audreifilhorossato/InkHand/docs/photos/F001.jpg

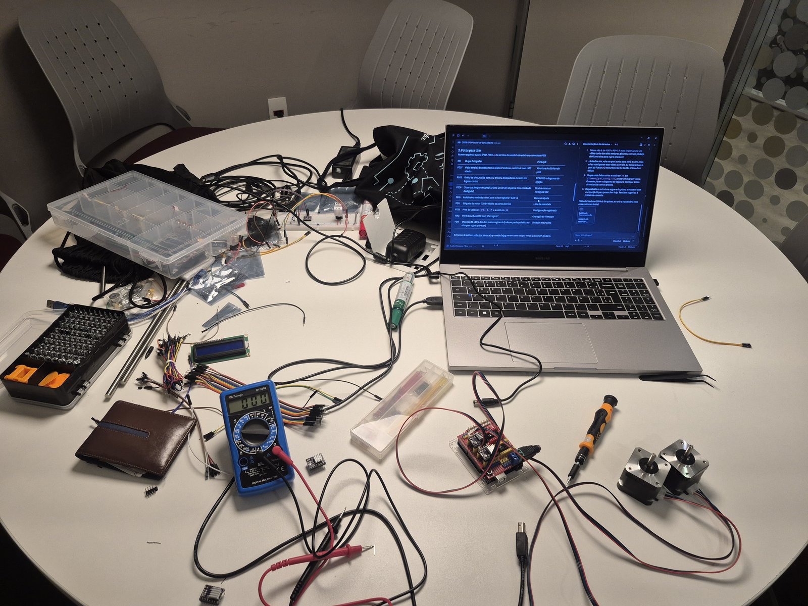
docs/photos/F001.jpg
