audreifilhorossato/InkHand/docs/photos/F002.jpg

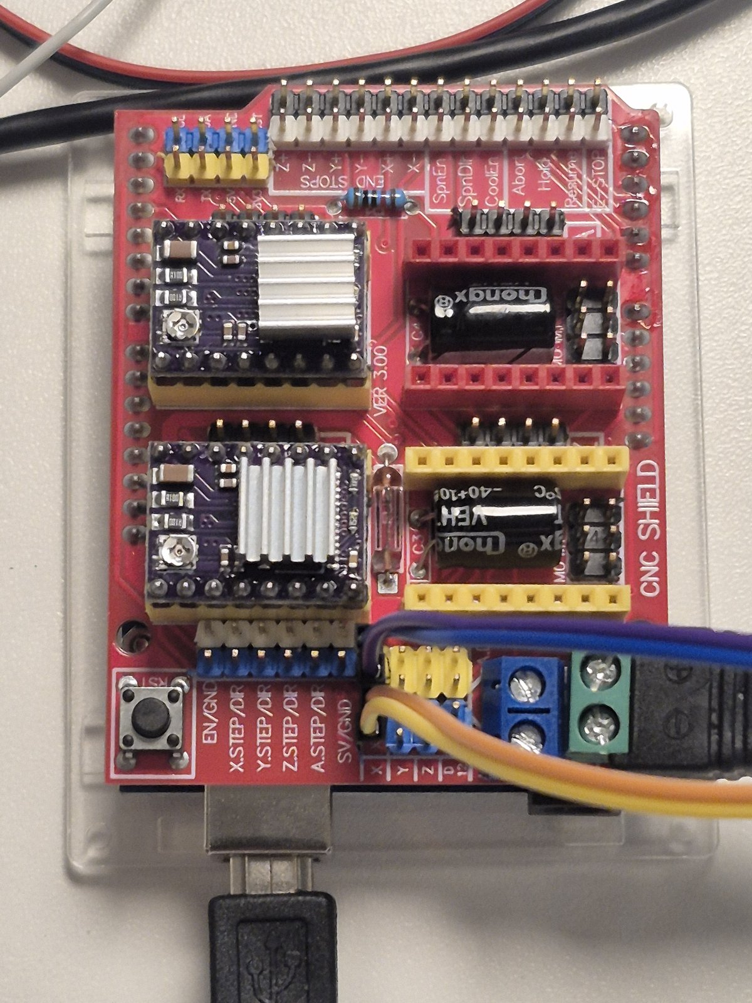
docs/photos/F002.jpg
