audreifilhorossato/InkHand/docs/photos/F003.jpg

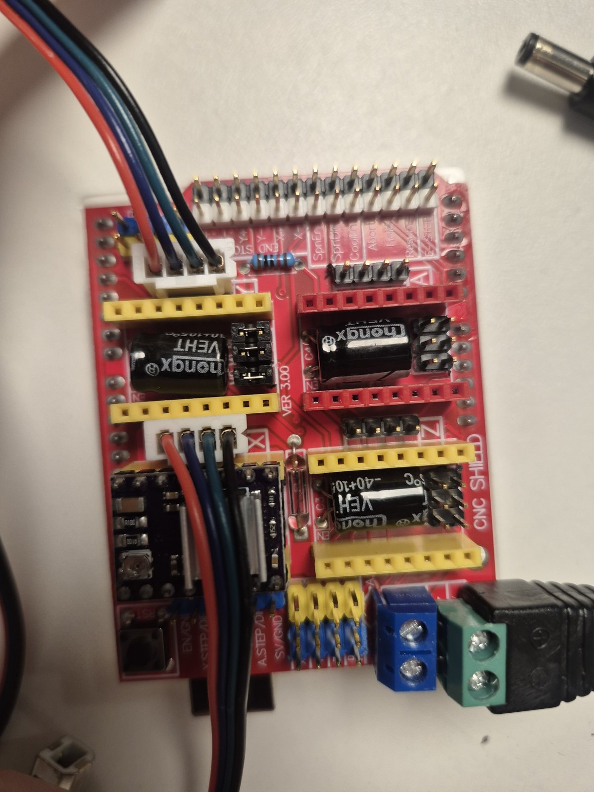
docs/photos/F003.jpg
