audreifilhorossato/InkHand/docs/photos/F004.jpg

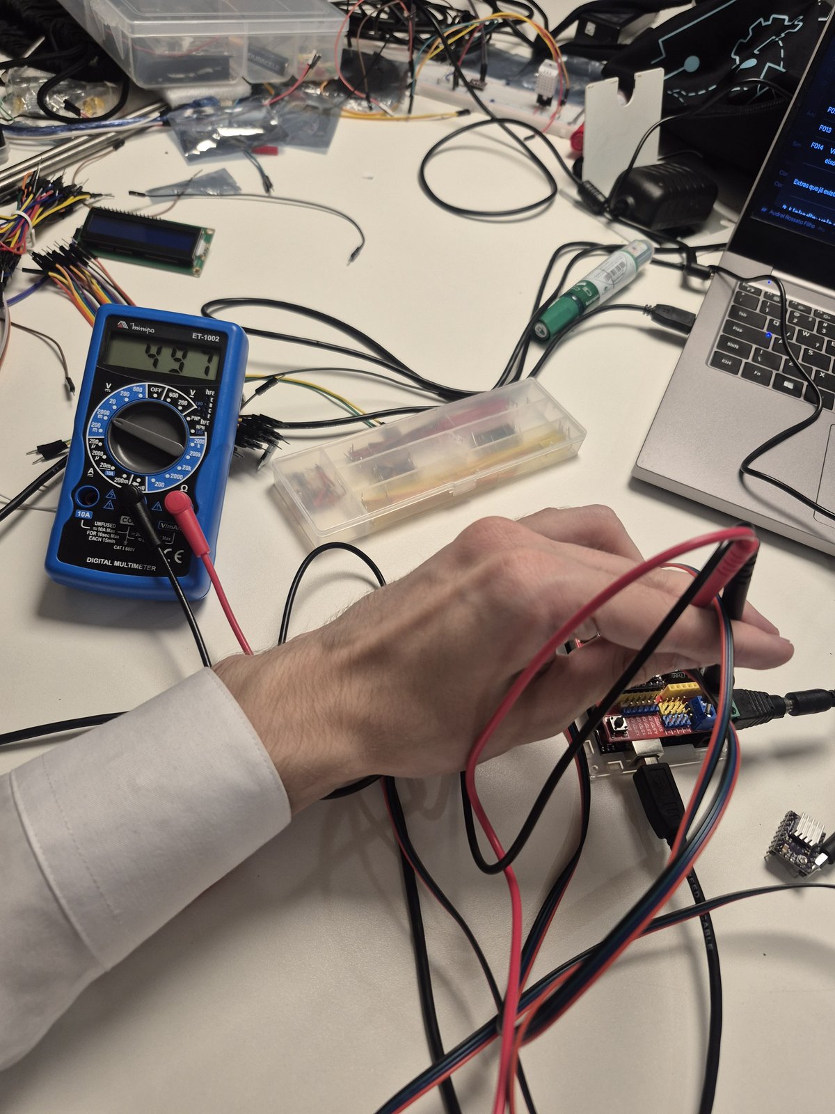
docs/photos/F004.jpg
