audreifilhorossato/InkHand/docs/photos/F005.jpg

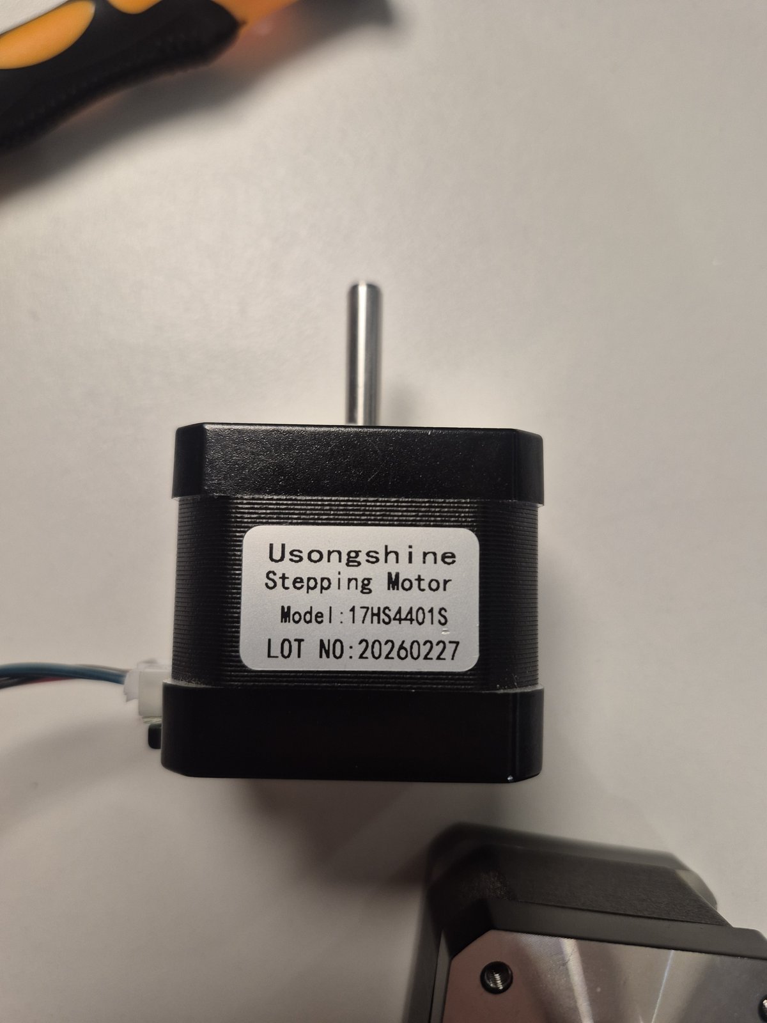
docs/photos/F005.jpg
