audreifilhorossato/InkHand/docs/photos/F006.jpg

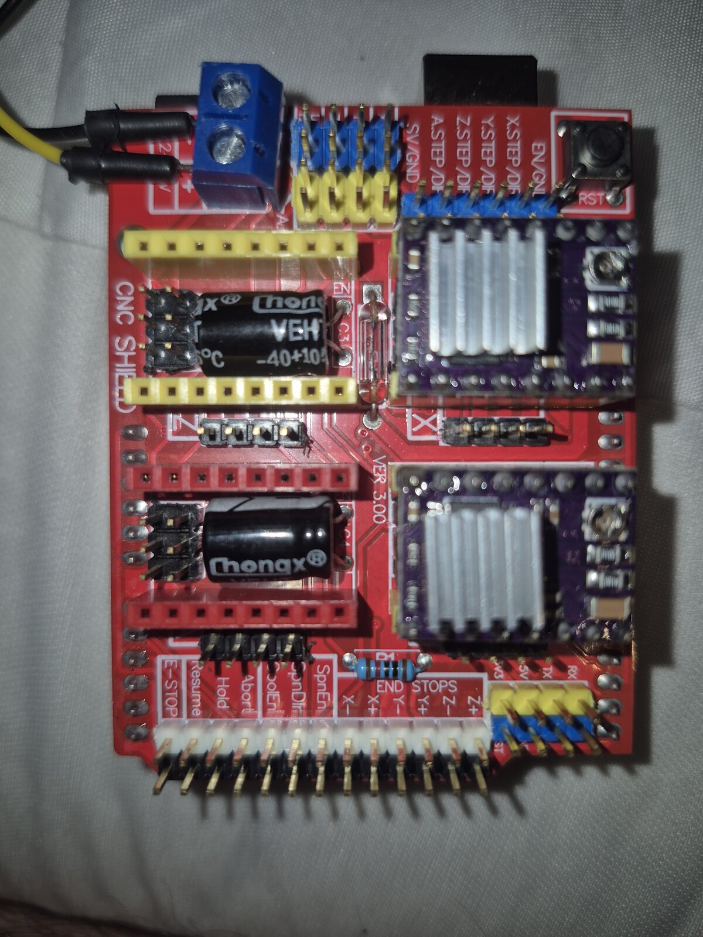
docs/photos/F006.jpg
