audreifilhorossato/InkHand/docs/photos/F007.jpg

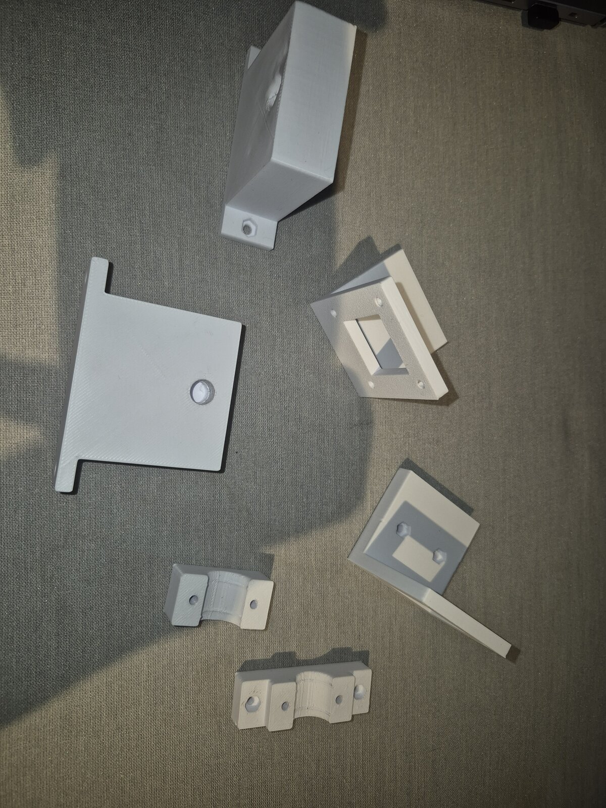
docs/photos/F007.jpg
