audreifilhorossato/InkHand/docs/photos/F008.jpg

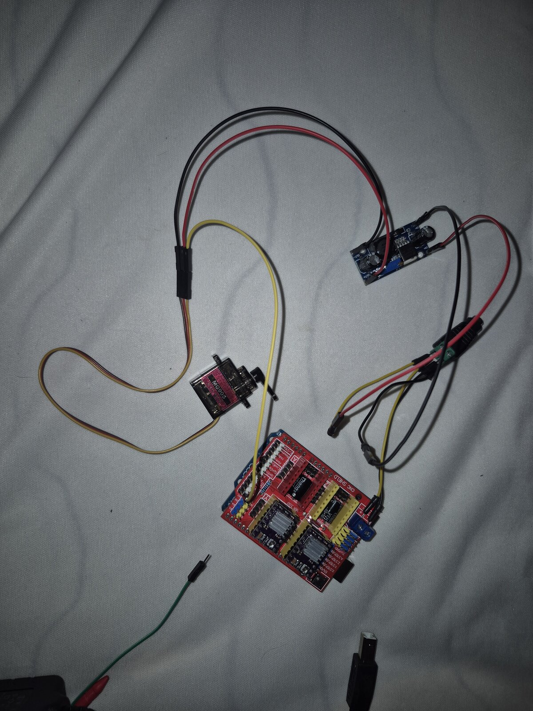
docs/photos/F008.jpg
