audreifilhorossato/InkHand/docs/photos/F009.jpg

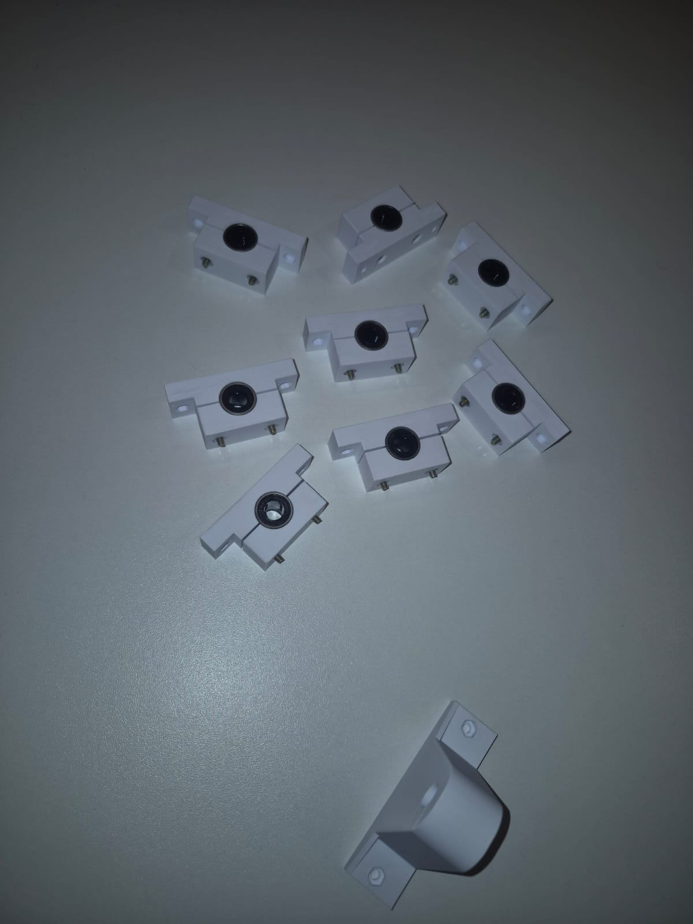
docs/photos/F009.jpg
