audreifilhorossato/InkHand/docs/photos/F010.jpg

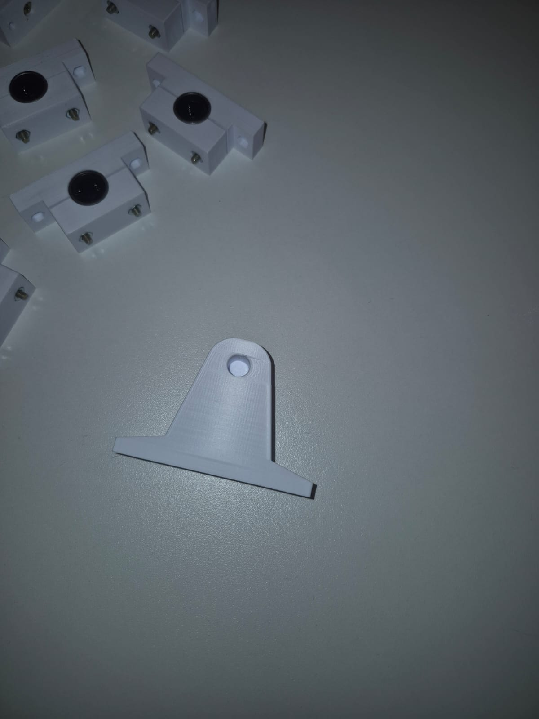
docs/photos/F010.jpg
