audreifilhorossato/InkHand/docs/photos/F011.jpg

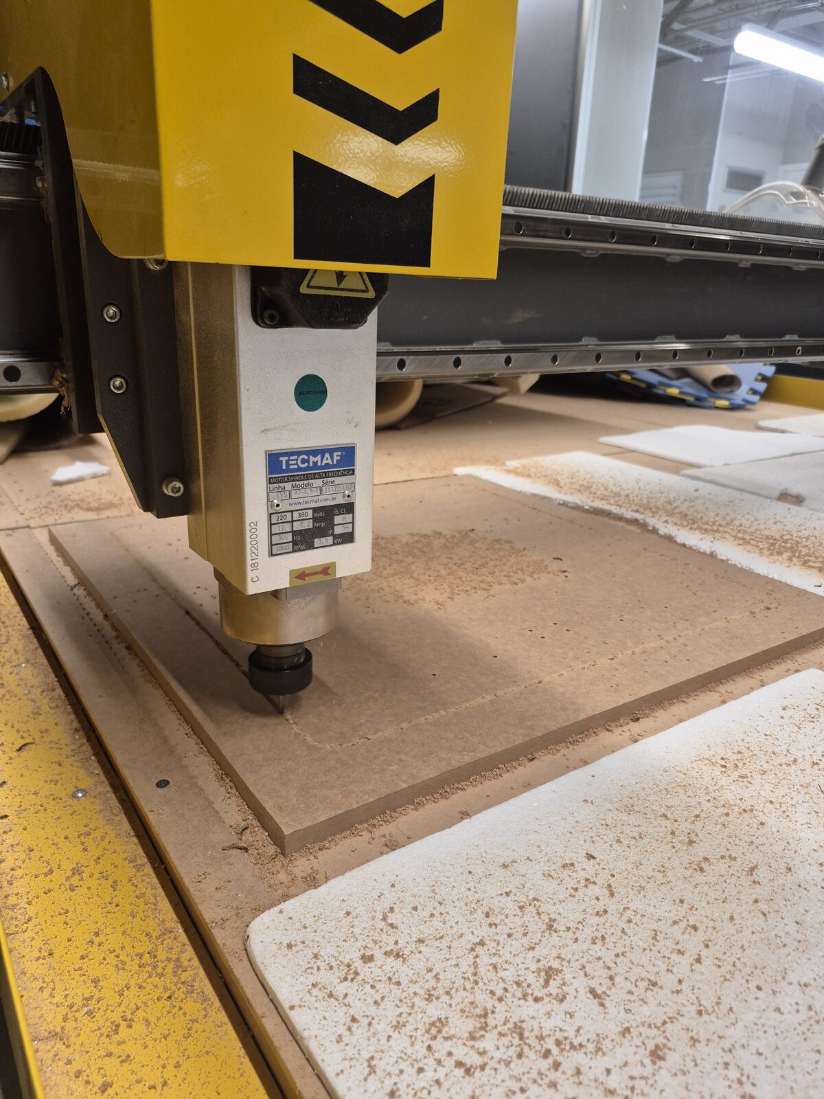
docs/photos/F011.jpg
