audreifilhorossato/InkHand/docs/photos/F012.jpg

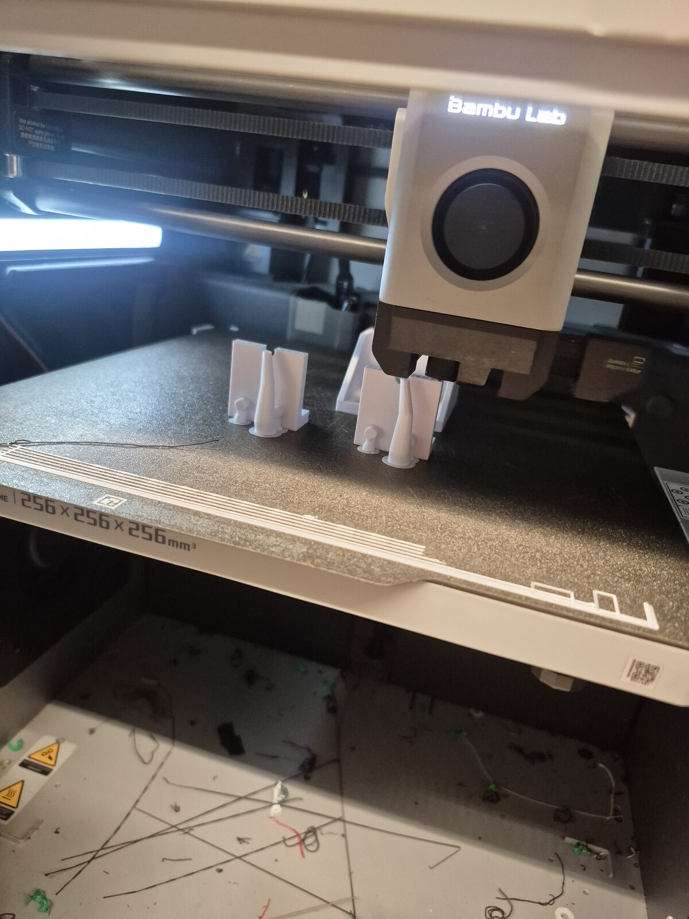
docs/photos/F012.jpg
