audreifilhorossato/InkHand/docs/photos/F013.jpg

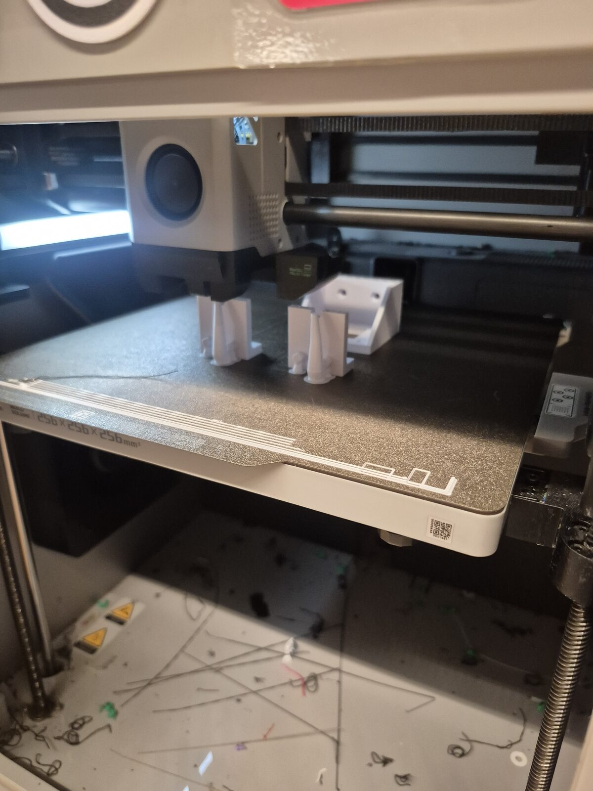
docs/photos/F013.jpg
