audreifilhorossato/InkHand/docs/photos/F014.jpg

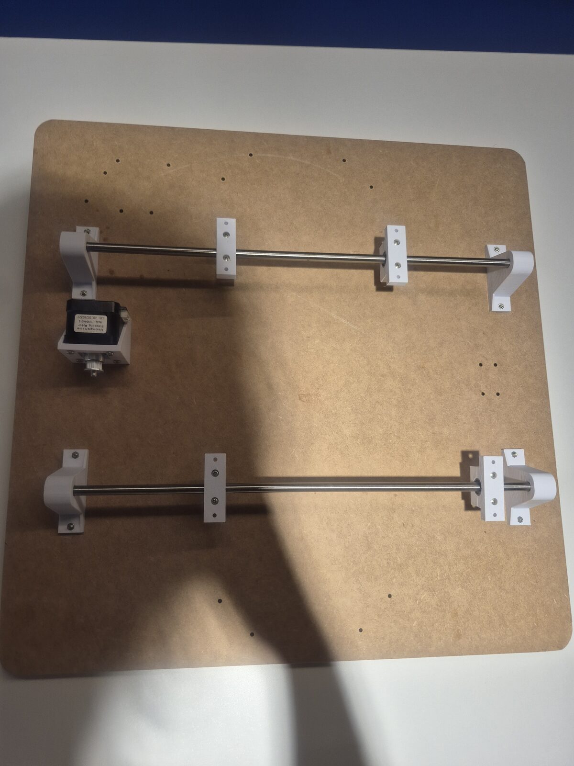
docs/photos/F014.jpg
