audreifilhorossato/InkHand/docs/photos/F015.jpg

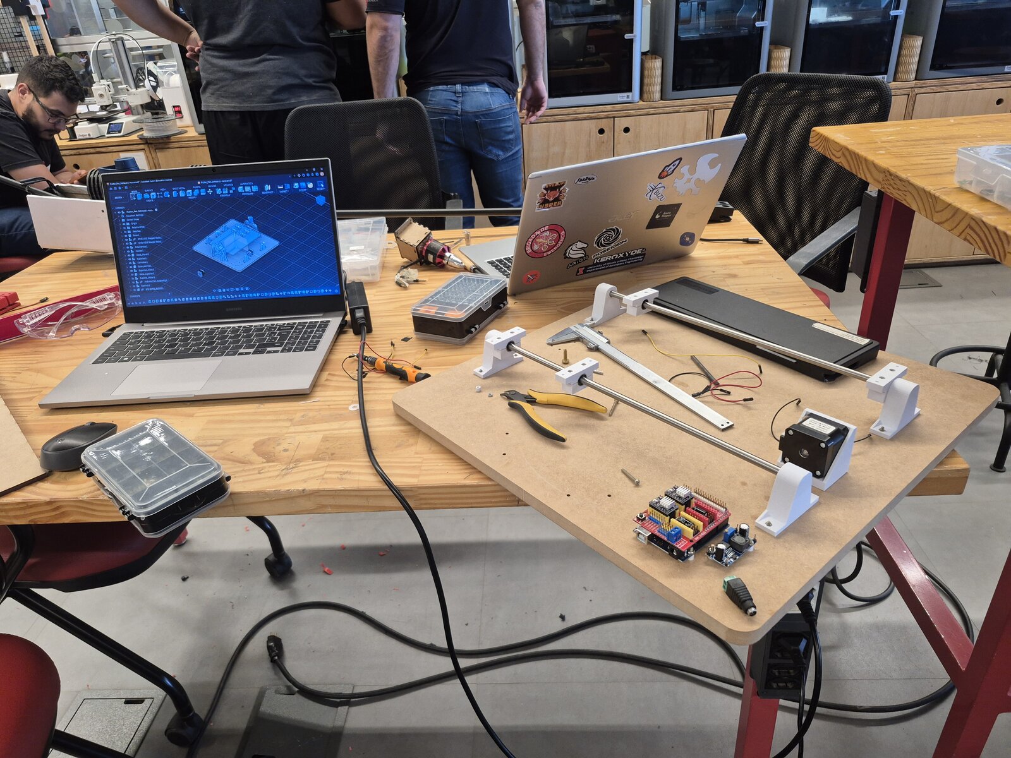
docs/photos/F015.jpg
