audreifilhorossato/InkHand/docs/photos/F016.jpg

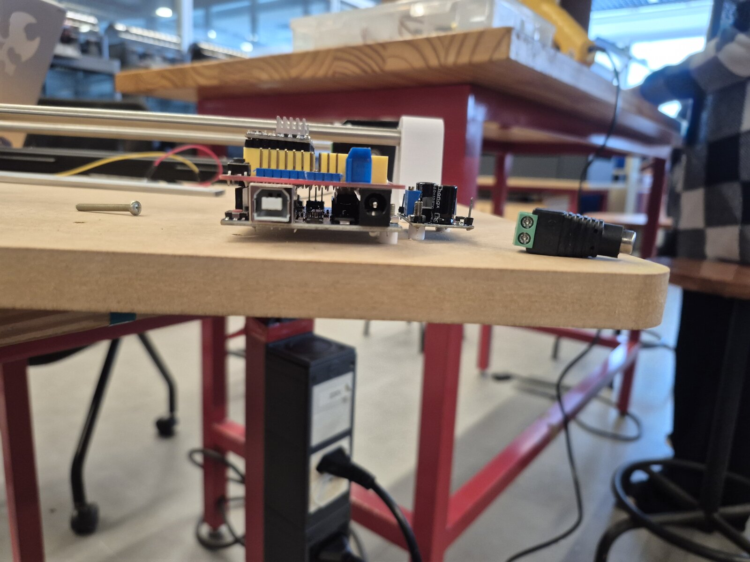
docs/photos/F016.jpg
