audreifilhorossato/InkHand/docs/photos/F017.jpg

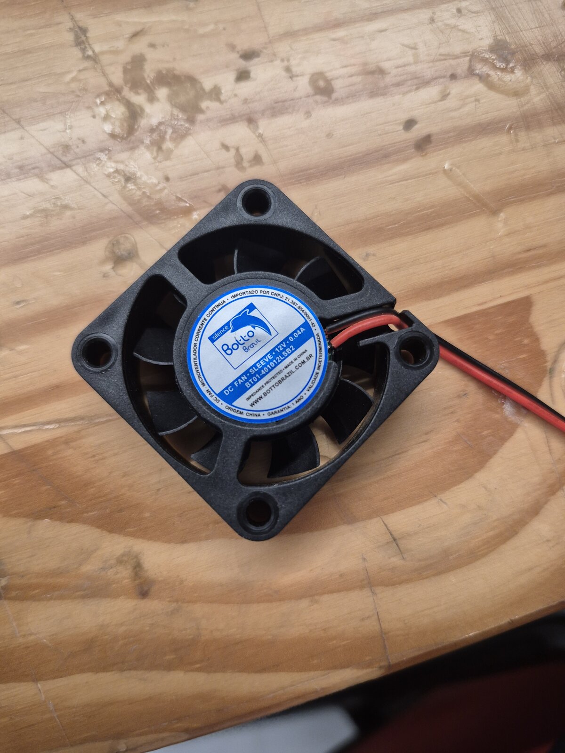
docs/photos/F017.jpg
