audreifilhorossato/InkHand/docs/photos/F018.jpg

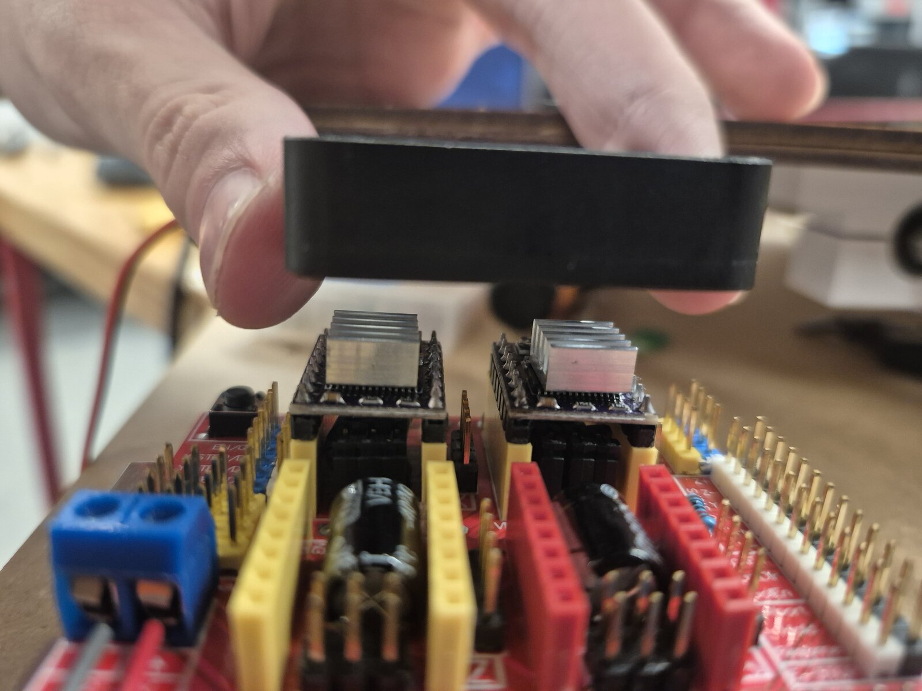
docs/photos/F018.jpg
