audreifilhorossato/InkHand/docs/photos/F019.jpg

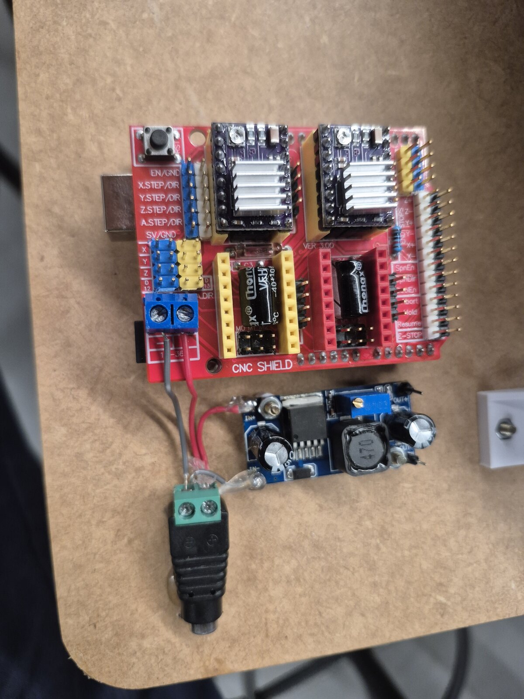
docs/photos/F019.jpg
