audreifilhorossato/InkHand/docs/photos/F020.jpg

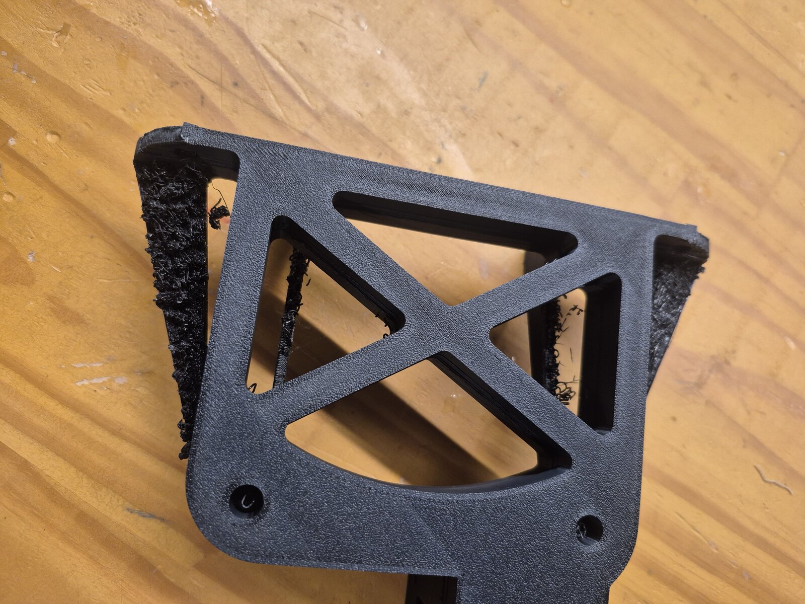
docs/photos/F020.jpg
