audreifilhorossato/InkHand/docs/photos/F021.jpg

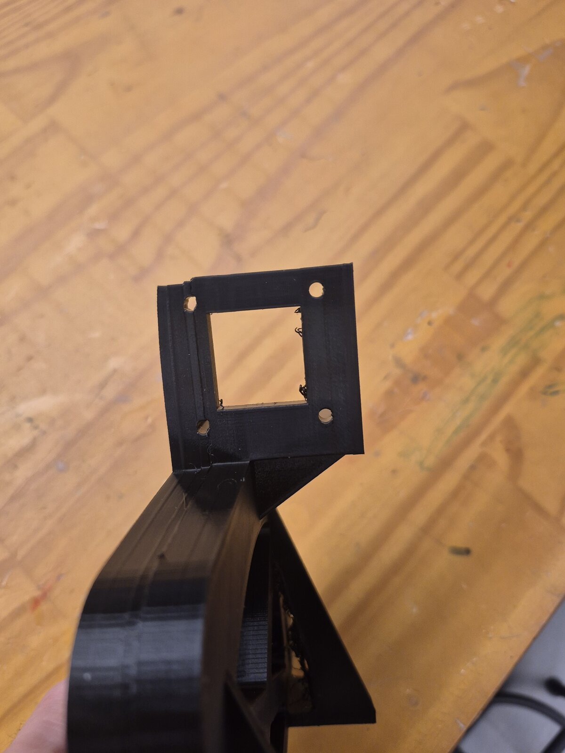
docs/photos/F021.jpg
