audreifilhorossato/InkHand/docs/photos/F022.jpg

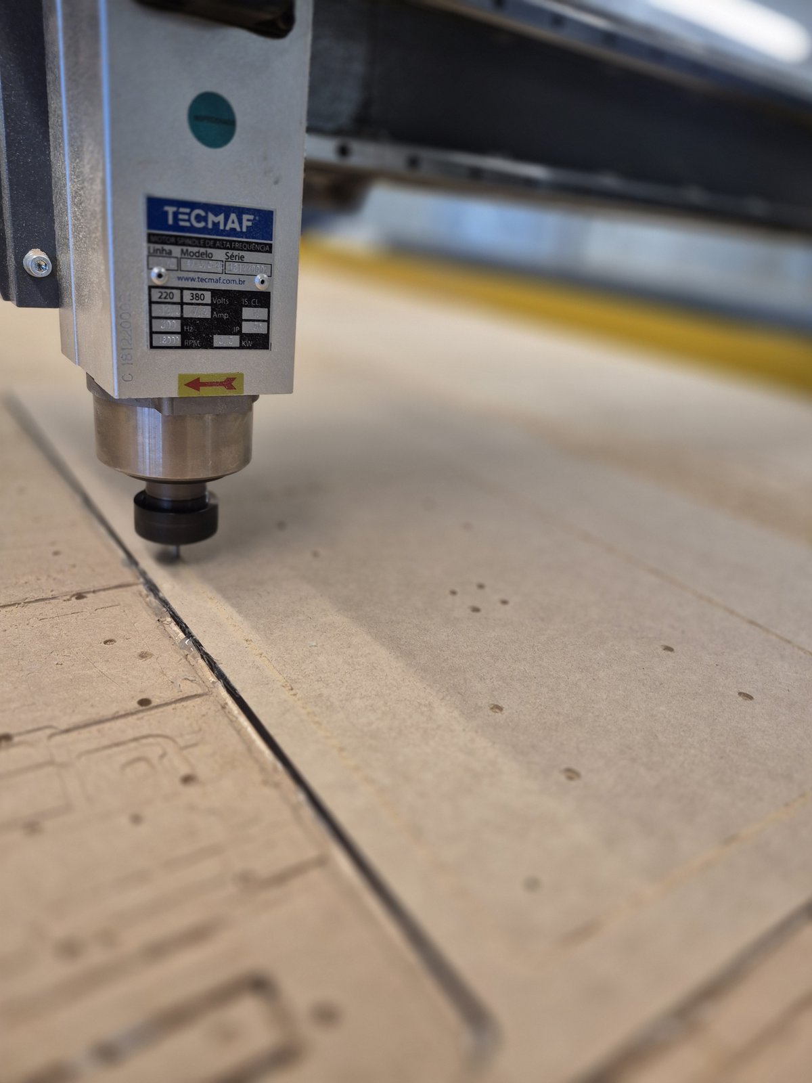
docs/photos/F022.jpg
