audreifilhorossato/InkHand/docs/photos/F023.jpg

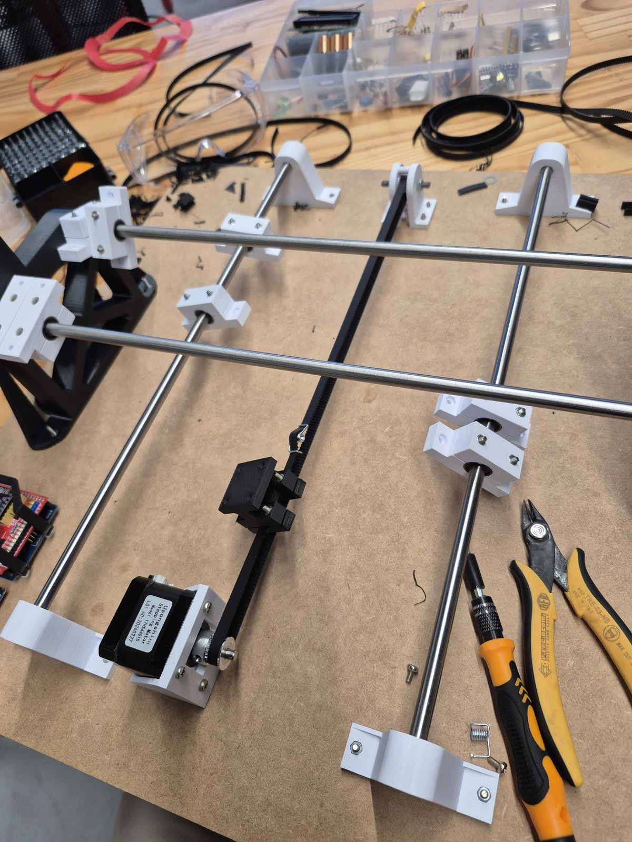
docs/photos/F023.jpg
