audreifilhorossato/InkHand/docs/photos/F024.jpg

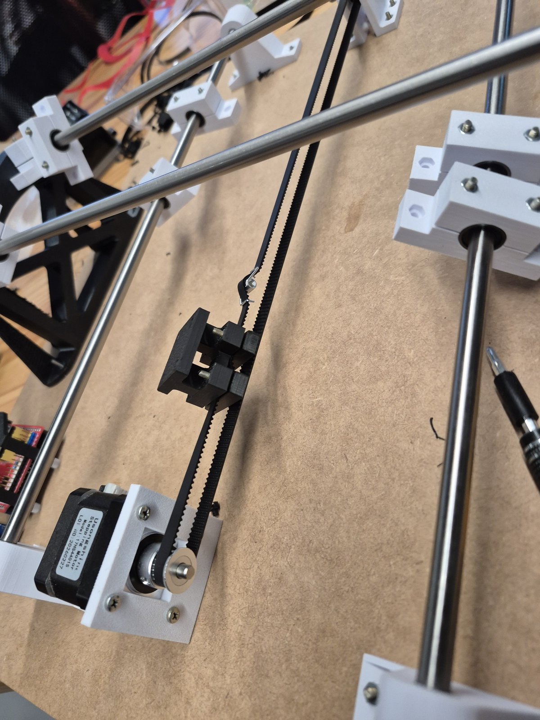
docs/photos/F024.jpg
