audreifilhorossato/InkHand/docs/photos/F025.jpg

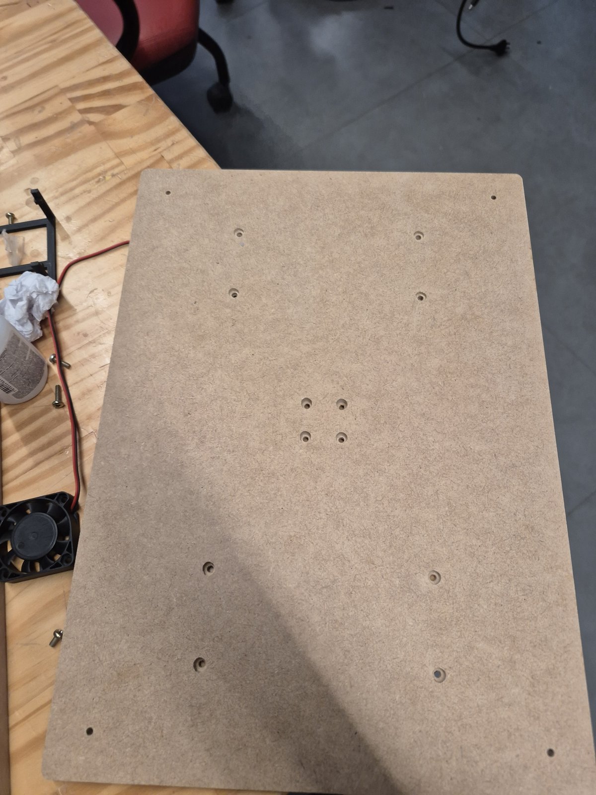
docs/photos/F025.jpg
