audreifilhorossato/InkHand/docs/photos/F026.jpg

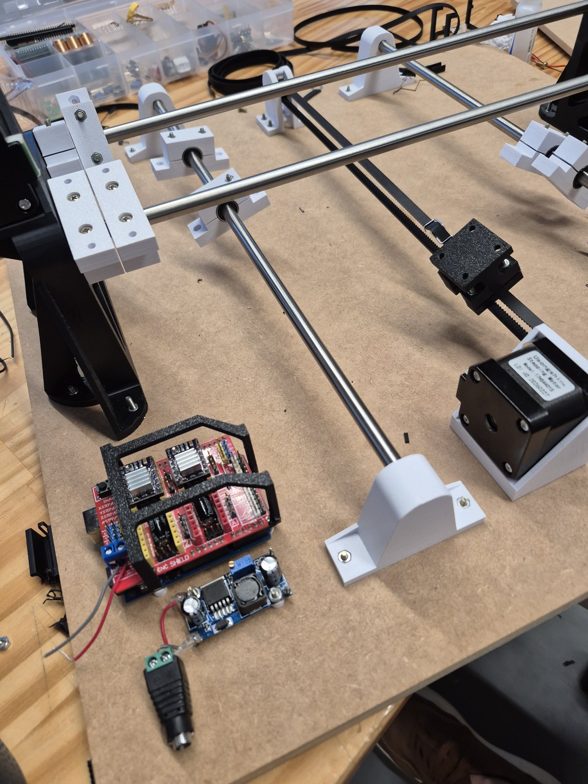
docs/photos/F026.jpg
