audreifilhorossato/InkHand/docs/photos/F027.jpg

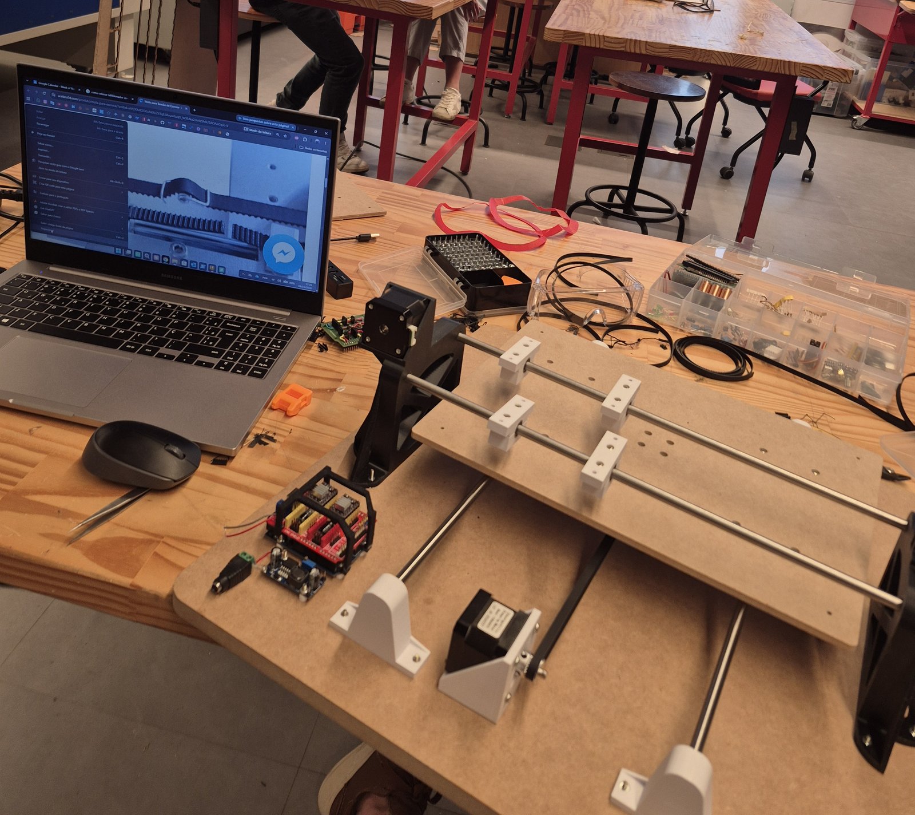
docs/photos/F027.jpg
