audreifilhorossato/InkHand/docs/photos/F029.jpg

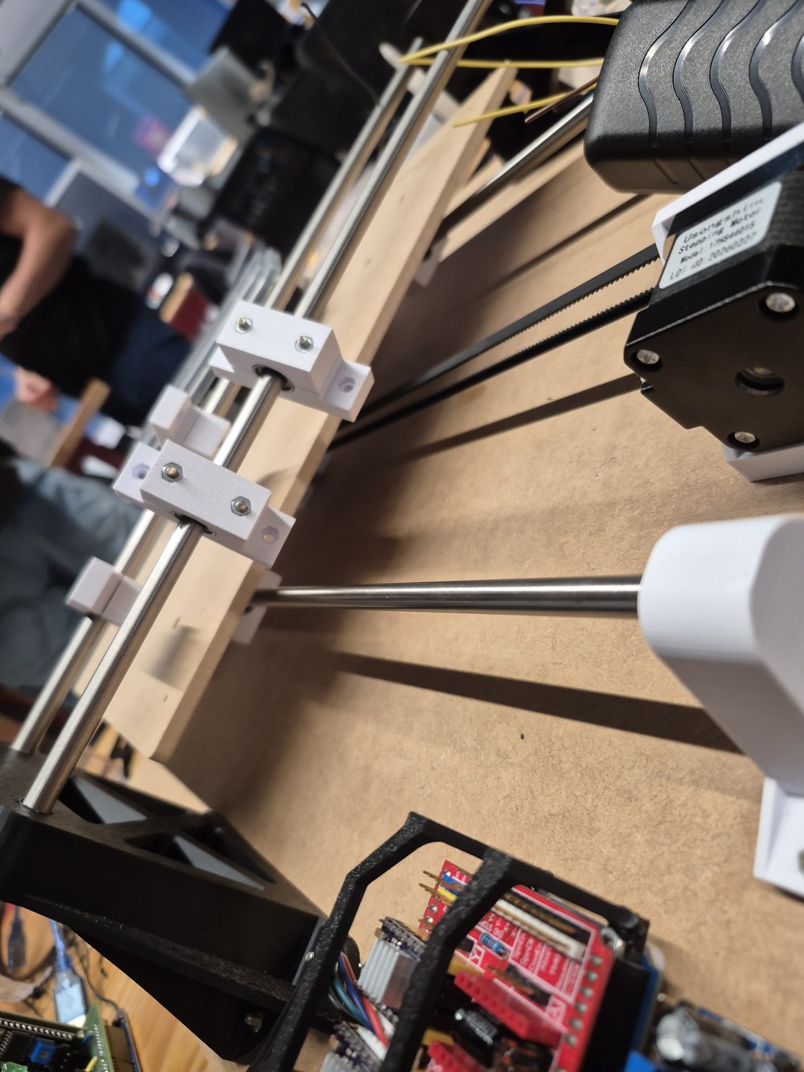
docs/photos/F029.jpg
