audreifilhorossato/InkHand/docs/photos/F030.jpg

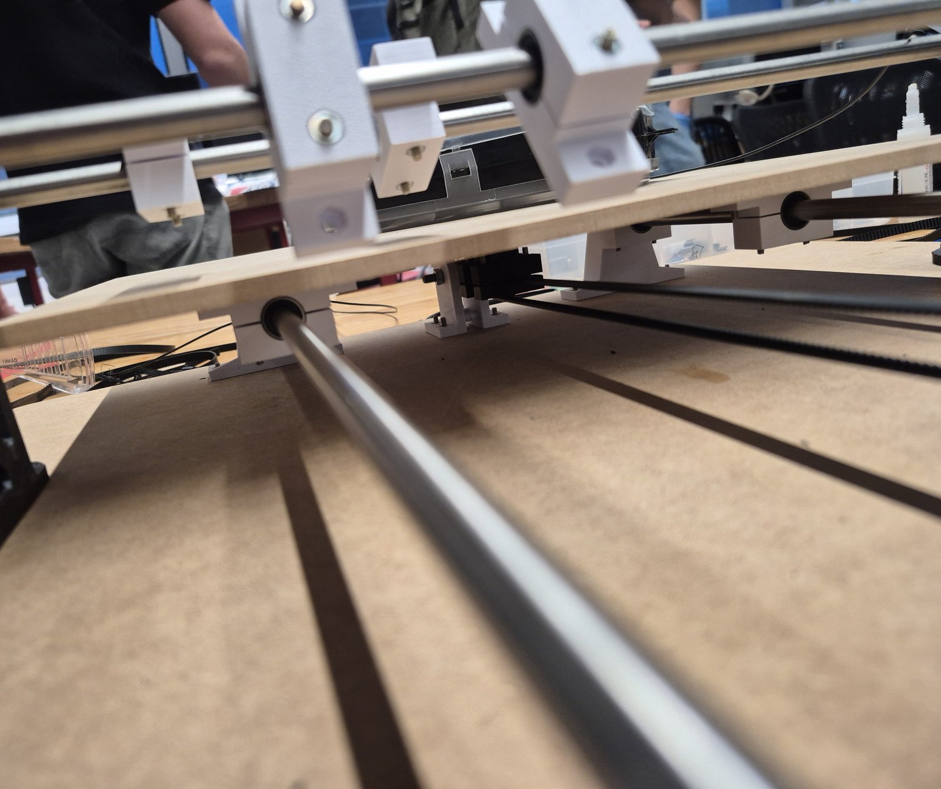
docs/photos/F030.jpg
