audreifilhorossato/InkHand/hardware/cad/Plotter_Pen_InkHand.step

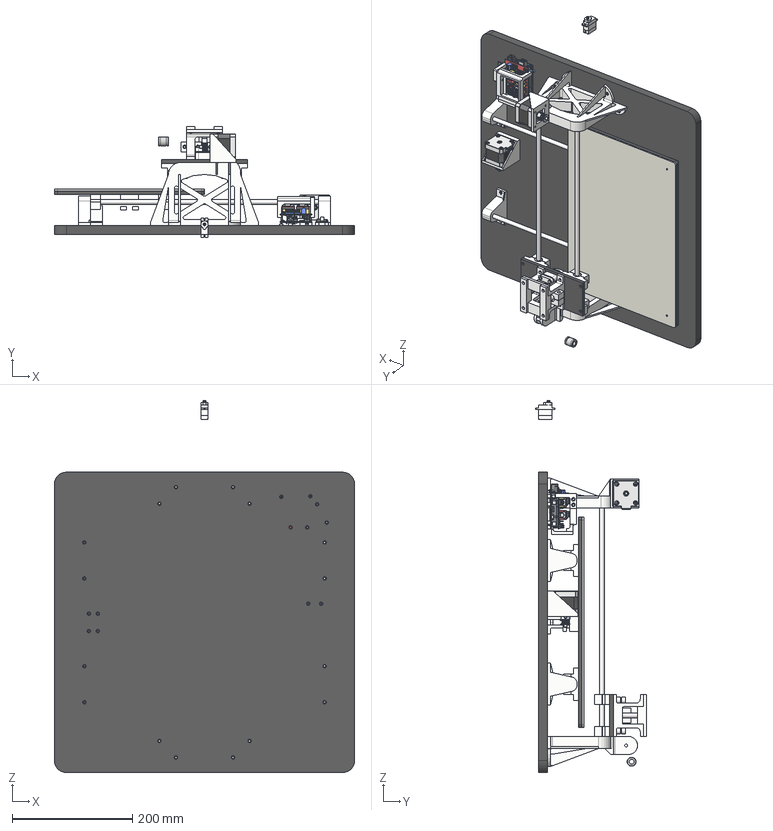
[picture p31: CAD file, 2026-11-14]
hardware/cad/Plotter_Pen_InkHand.step
500.0 x 184.1 x 619.3 mm
