audreifilhorossato/InkHand/hardware/cad/writing-sheet.dxf

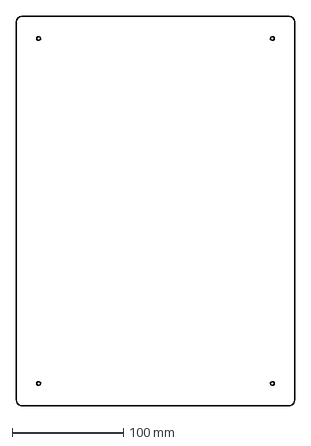
[picture p32: CAD file, 2026-11-11]
hardware/cad/writing-sheet.dxf
250.0 x 350.0 mm
