audreifilhorossato/InkHand/(list of files, cad)

Other CAD files:
hardware/cad/Plotter_Pen_InkHand.f3z
