audreifilhorossato/InkHand/docs/journal/README.md

# Lab journal

The source of truth is a handwritten lab notebook (numbered pages, in Portuguese).
Each session is transcribed here in English, one file per session: `YYYY-MM-DD.md`.
Days with no notebook pages can share one entry, named after the first and last day: `YYYY-MM-DD_to_YYYY-MM-DD.md`.

Template:

```
# YYYY-MM-DD · Session N · Topic
Goal / Done / Measurements / Problems → fixes / Decisions and why / Pending / Photos / Next step
```

Photos are numbered in order across sessions (`docs/photos/F001.jpg`, `F002.jpg`, …) and listed in the session's entry.
Scans of the notebook pages are kept out of the public repo because they show my handwriting.

| Date | Session | Summary |
|---|---|---|
| [2026-10-08](2026-10-08.md) | 1 | Parts arrived, shopping list and repository plan |
| [2026-10-09](2026-10-09.md) | 2 | Electronics bench test: drivers, GRBL, X/Y motors working |
| [2026-10-10](2026-10-10.md) | 3 | Repository created, first Fusion 360 parts (base, rods, bearings, motors) |
| [2026-10-11](2026-10-11.md) | 4 | Frame chosen (fixed gantry in X, moving bed in Y), Y axis in Fusion 360: rod supports, bearing blocks, bed |
| [2026-10-12](2026-10-12.md) | 5 | Holes and joints fixed, writing sheet, X gantry in Fusion 360: uprights, rods side by side, carriage. Servo and LM2596 arrived |
| [2026-10-13 to 2026-10-17](2026-10-13_to_2026-10-17.md) | 6 | No notebook pages. Servo and LM2596 tested, draft prints (rod holes Ø7.8 → Ø8.0), motor mounts, Arduino + CNC Shield and GT2 pulleys in Fusion 360 |
| [2026-10-19](2026-10-19.md) | 7 | Counterbores 3.0 → 3.3 mm, LM2596 and servo in Fusion 360, Y motor placed and its mount reinforced, first 4 final bearing blocks printed |
| [2026-10-20](2026-10-20.md) | 8 | No notebook page. Lighter rod supports and upright (X windows), all 8 bearing blocks printed and assembled, test print of a rod support, print settings |
| [2026-10-22](2026-10-22.md) | 9 | No notebook page. Idler support drawn (from a plate to a fork) with its holes in the base, the other 3 rod supports printed |
| [2026-10-23](2026-10-23.md) | 10 | No notebook page. Belt line, base machined on a CNC router (counterbores redone by hand), idler supports and Y motor mount printed, Y axis assembled on the base, X motor mount started |
| [2026-10-26](2026-10-26.md) | 11 | No notebook page. Uprights redrawn: one with the X motor plate, one with the X idler fork, idler axle at the height of the motor shaft. Fan support drawn. First upright print failed overnight |
| [2026-10-27](2026-10-27.md) | 12 | No notebook page. Arduino, LM2596 and 12 V input fixed and wired on the base, one Arduino standoff shortened, 40 mm fan placed over the drivers, 2 uprights printed again |
| [2026-11-05](2026-11-05.md) | 13 | No notebook page. Belt support drawn under the middle of the bed with its 4 holes in the bed, first CNC program for the bed, fan support v2 (bigger hooks, printed with 3 walls) |
| [2026-11-06](2026-11-06.md) | 14 | No notebook page. Bed with R5 corners cut on the CNC (Stock to Leave and work offset fixed in the program), clamp plates printed, Y belt fitted with its spring, fan support v3 broke and was glued, the whole machine assembled. The belt clamp is 6 mm under the belt line |
| [2026-11-10](2026-11-10.md) | 15 | No notebook page, no photos. Writing sheet laser-cut in 3 mm acrylic (R5 corners), Y belt support 4 mm shorter, X belt clamp on the carriage plate and its holes, fan box in 2 parts, new parts printed on an A1 mini, X motor placed in the model. Pen lift chosen: a pen carriage on 2 vertical rods, pushed up and down by the servo |
| [2026-11-12](2026-11-12.md) | 16 | No notebook page, no photos. Pen lift (Z) support drawn on the X carriage plate: a frame with 2 vertical Ø8 rods and caps, the X belt passing through the middle. Fan box with one leg now screwed on (the stiffer print no longer bends to snap in), Y clamp plates with Ø6.4 counterbores. Machine still taken apart |
| [2026-11-13](2026-11-13.md) | 17 | No notebook page, no photos. Yesterday's prints all came out wrong and were redrawn: Z frame and caps with solid bases and Ø8.6 rod sockets, fan box with a 2-screw leg and back on the Arduino holes, Y belt support as a solid block with 8 nuts printed in. Belt support printed and fitted, Y belt tensioned, Z rods cut, motor wires routed. A bearing block on one Z rod in the model |
