audreifilhorossato/InkHand/docs/journal/2026-10-27.md

# 2026-10-27 · Session 12 · Electronics on the base, fan, failed upright print

No notebook page.

*Nothing was written in the notebook today. This entry is built from what I said about the two days, the questions I asked about the fan, the photos of the day and the Fusion 360 export of the evening of the 28th. The split between this entry and [2026-10-26](2026-10-26.md) is a reconstruction. The work of the 28th (assembly) is not in this entry.*

## Done
- **Electronics fixed on the base** (F015 to F017, F019): the Arduino with the CNC Shield, the LM2596 and the 12 V input (the DC barrel jack adapter), each screwed to the base.
- **LM2596 wired straight to the 12 V input.** The module had 2 header pins soldered on for a breadboard. I desoldered them and soldered short wires in their place, going straight to the screw terminal of the DC jack, so the wiring is tidier.
- **Hot glue** over the screw terminal and over every solder joint, to avoid short circuits and to hold the wires.
- **One Arduino standoff redone.** One of the 4 holes of the Arduino is too close to the components for a nut to fit on top of the board. I made that standoff shorter and reprinted it, then printed the small standoffs again (quick prints) and fitted the Arduino. For now it is held by 3 of its 4 holes.
- **Fan placed and its height worked out** (F017, F018), so it doesn't touch the bed. Questions and answers below.
- **The failed upright** from the night before: the print had shifted and the part came out crooked (F020, F021). I started 2 new uprights, which were ready on the 28th and came out well.

The electrical part took most of the day.

## The fan
A 40 mm fan from the lab (Botto Brasil, sleeve bearing, 12 V, 0.04 A), to blow on the two drivers (F017). I asked whether it was strong enough, at what height to put it, whether it was needed at all, how to power it and which side is which. The answers, in short:
- **Size.** A 40 mm fan is enough. The big hub is normal for this size.
- **Height.** 10 to 15 mm between the blades and the top of the heatsinks is ideal. Too close leaves a dead spot under the hub; too far and the air spreads before it reaches the drivers. I only have room for about 5 mm, which works: centred between the two drivers, the hub is over the gap between them and both heatsinks get air from the blades (F018).
- **Is it needed?** At plotter currents (the DRV8825s are set to 1.0 A, Vref 0.50 V) the drivers get warm and work without a fan. It's worth it inside a closed box or with more current. It's cheap and quiet, so I'm fitting it, as insurance against a driver losing steps when it heats up in a long drawing. Test: run a 20-minute drawing without the fan and touch the heatsink; if you can keep your finger there, it's fine.
- **Power.** It's a 12 V fan, so it goes on the 12 V input, before the LM2596, never on the 5 V output. Red to +, black to −; reversed, it doesn't turn.
- **Current.** Everything on the 12 V supply is in parallel: the supply holds 12 V and each load draws only what it needs. The currents add up: the 2 motors up to about 1.5 to 2 A, the Arduino and the servo through the LM2596 about 0.3 to 0.5 A, the fan 0.04 A. About 2.5 A in total, well under the 5 A of the supply.
- **Which side.** The air comes out on the side with the sticker. To blow on the drivers, **the sticker faces down, towards the board**. To check, switch it on and hold a hand or a strip of paper on each side. Many fans also have two small arrows on the frame, one for the airflow and one for the rotation.

## Problems → fixes
- **The upright print failed overnight.** I think the power went out. The layers shifted, and the motor plate came out tilted on the gusset (F021). → Printed 2 new uprights, ready on the 28th.
- **No room for a nut on one Arduino hole.** The Arduino has holes for screws, but on one of them the nut doesn't fit on top of the board, because the hole is too close to the components. → A shorter standoff under that hole (5 → 2.7 mm in the model). For now the Arduino is held by the other 3 holes. To improve over time.

## What changed in the model
Compared with [2026-10-26](2026-10-26.md#what-changed-in-the-model):
- **Arduino standoff.** The standoff under the Arduino hole at the far corner from the LM2596 is 2.7 mm tall instead of 5 mm (`Suportes_eletrica`, 0.56 → 0.52 cm³). The other 5 are unchanged.

## Pending
For both days:
- Fan: drill its holes in the support and fix it with the sticker facing the board, then wire it to the 12 V input.
- Check the clearance between the fan and the bed (about 1 mm in the model, see the [checks of the 26th](2026-10-26.md#checks-before-building)).
- Run a 20-minute drawing and check how warm the drivers get.
- X axis: fit the 2 uprights on the base with the X rods and the carriage, the X motor on its plate and the X idler in its fork, then the X belt and its clamp.
- Decide where the pen goes, since the X belt runs over the middle of the carriage, then draw the pen lift (Z) with the servo.
- Y axis (from the [23rd](2026-10-23.md#pending)): screw the idler support down, put the bed on, make the belt clamp at the belt line and fit the Y belt.
- Save the `$$` output in [firmware/grbl_config.txt](../../firmware/grbl_config.txt).
- Fill the misplaced counterbores under the base, only for looks.

Also still to do:
- Route the cables.
- Import the screws, nuts and other standard parts into Fusion, all at once at the end.

## Photos
| # | Photo |
|---|---|
| F015 | [My bench at the lab: the model in Fusion 360 on the laptop, and the base with the Y axis and the electronics laid out](../photos/F015.jpg) |
| F016 | [The Arduino with the CNC Shield, the LM2596 and the DC jack at the edge of the base, from the side](../photos/F016.jpg) |
| F017 | [The 40 mm fan, 12 V 0.04 A, sticker side up](../photos/F017.jpg) |
| F018 | [Holding the fan over the two drivers to find its height](../photos/F018.jpg) |
| F019 | [The electronics screwed to the base and wired: the DC jack, the LM2596 and the shield's 12 V terminal](../photos/F019.jpg) |
| F020 | [The upright from the failed print, with the X windows and support marks on the sides](../photos/F020.jpg) |
| F021 | [The same print from the motor plate: the layers shifted and the plate came out tilted](../photos/F021.jpg) |

## Fusion 360
CAD exports of the evening of the 28th, at commit 6502bf6: [STEP](https://github.com/audreifilhorossato/InkHand/blob/6502bf6/hardware/cad/Plotter_Pen_InkHand.step) · [Fusion 360 archive (.f3z)](https://github.com/audreifilhorossato/InkHand/blob/6502bf6/hardware/cad/Plotter_Pen_InkHand.f3z). The files in `hardware/cad/` now hold the latest export.

## Next step
Fit the 2 new uprights with the X rods and the carriage, then the X motor, the X idler and the X belt.
