audreifilhorossato/InkHand/docs/journal/2026-10-23.md

# 2026-10-23 · Session 10 · Base machined on the CNC, Y axis assembled

No notebook page.

*Nothing was written in the notebook today. This entry is built from what I said about the two days, the question I asked about the belt line, the photos and the video of the day, the CNC setup saved in the Fusion 360 file and the export of the evening of the 24th. The split between this entry and [2026-10-22](2026-10-22.md) is a reconstruction.*

## Done
- **Belt line checked.** I sketched the Y belt and asked whether the angle between the pulleys and the clamp under the bed matters. It does, and the clamp has to come down to the belt line (below).
- **CNC setup in Fusion 360** (the Manufacture workspace) for the base: the tools, the holes, the counterbores and the outline.
- **Base machined on the lab's CNC router** from a 600 × 600 × 15 mm MDF sheet (F011). The outline and the 28 through holes came out right. The counterbores didn't, because of a fault on the machine's Y axis.
- **Counterbores drilled by hand** with a hand drill.
- **Printed** the 2 idler supports and the reinforced Y motor mount, on one plate, with the same [settings as on 2026-10-20](2026-10-20.md#print-settings) (F012, F013). Both prints went well. The idler supports aren't screwed to the base yet.
- **Y axis assembled on the base** (F014): the 4 rod supports, the 2 Y rods, the 4 bearing blocks and the Y motor in its mount. Still to fit: the bed, the idler support and the belt.
- **X motor mount started:** a new, lighter version of the second motor mount, still floating over the upright. It will get a seat on top of the upright.
- **New STEP and .f3z exports**, on the evening of the 24th.

## Belt line
While drawing the idler support I noticed that the belt can't line up with the clamp under the bed. The two pulleys are at the same height, so the lower run of the belt is straight, but the clamp is higher than the top of the pulleys. The top run goes up to the clamp and down again, making a triangle, and the triangle changes shape as the bed moves towards one end. I asked whether that only changes the force of the motor or really affects something. The answer, in short:
- **It affects the accuracy.** GRBL assumes that each mm of belt the motor winds is 1 mm of bed travel. With the belt at an angle, the belt runs along the hypotenuse of the triangle, not along the rods. The error grows near the motor, where the angle is steepest. With 5 mm of height difference, the belt is about 0.6 mm longer with the clamp 20 mm from the motor, 0.25 mm at 50 mm and 0.06 mm at 200 mm. The error changes with the position, so calibrating the steps/mm can't remove it.
- **The tension changes along the travel.** The two sides of the triangle add up to more near the ends than in the middle. The belt is a closed loop, so it gets tighter at the ends and slacker in the middle.
- **Part of the pull goes up or down**, and that also changes with the position. It loads the rods and can tilt the bed a little, which changes the pressure of the pen.
- **Wear is small**, because the angle is in the plane of the pulley. What wears a belt is a sideways misalignment that makes it climb a flange.

What has to be straight is the **belt line**: the top of the motor pulley, the top of the idler and the face of the clamp where the belt's teeth sit. When both pulleys have the same diameter, both runs are then parallel to the rods. The aim is zero difference. Up to 1 mm is acceptable, about 0.025 mm of error at 20 mm from the motor, and shims under the clamp give a fine adjustment after assembly.

In my case the two pulleys already line up with each other, so it's the clamp that has to come down to the belt line. If a lower clamp hits the motor or the pulley, both pulleys can go up by the same amount instead.

In the model, the motor pulley and the idler both have 20 teeth and their axes are 30 mm above the base, so the top run of the belt is at about 36.4 mm and the underside of the bed at 51.5 mm. The clamp has to reach about 15 mm under the bed.

## Machining the base on the CNC
The base (500 × 500 × 15 mm, R20 corners, 28 holes with counterbores) was machined on the lab's CNC router, out of a 600 × 600 × 15 mm MDF sheet. The setup was done in the Manufacture workspace of Fusion 360 and was the slow part: registering the tools and setting up each operation.

| Operation | Tool | What it cuts |
|---|---|---|
| Drill1 | T2, Ø3.5 mm drill, 10,000 rpm, 1,000 mm/min | The 28 through holes |
| 2D Contour2 | T1, Ø4 mm flat end mill, 2 flutes, 10,000 rpm, 3,100 mm/min, plunging at 800 mm/min | The 28 counterbores, Ø6 × 3.3 mm |
| 2D Contour1 | T1, the same end mill | The outline, in steps of 1.6 mm, 0.1 mm below the sheet |

- **Stock:** a fixed 600 × 600 × 15 mm box, with the base in the middle and the origin at a corner of the top face. The counterbores are on the underside of the base, so the sheet was machined with that face up.
- **Post processor:** Mach3 (`mach3mill.cps`).
- **NC programs:** 5 are left in the file from the attempts: `furação`, `usinagem`, `USINAGEM2`, `CONTORNO` and `CONTORN3`.

## Problems → fixes
- **The CNC's Y axis was faulty.** The through holes and the outline came out in the right place. The counterbores came out the right size but in the wrong place, shifted up or to the side of their hole, on 6 or 7 holes. Each run put them somewhere else. We checked the file and ran it several times, and the lab technicians confirmed that the fault was in the machine. → I drilled the counterbores by hand with a hand drill, around the through holes. With no depth stop, some came out deeper than others, but all of them hide the screw heads under the base. The misplaced recesses stay as they are for now. Later I'll fill them with wood glue and MDF dust, or resin, only for looks.
- **The screws of the motor mount.** The 2 screws that hold the Y motor mount to the base go up from under the base into the foot, under the motor. In the model I put the nut pockets too high in the foot, so each screw had to end exactly in its nut without touching the motor. → I adjusted each screw with washers and nuts until it stood at the right height, then fitted the mount over it, turned it and tightened. It worked. The mistake was putting the motor over its own screws: they should be outside the motor, on the sides of the foot. This was a check on [2026-10-20](2026-10-20.md#checks-before-building).

## What changed in the model
Compared with [2026-10-22](2026-10-22.md#what-changed-in-the-model):
- **X motor mount.** The old second mount (43 mm wide, 9 mm foot, no gussets) became a new mount for the X motor: a 5 mm foot instead of 9 mm, 2 side gussets 3 mm thick like the Y mount, and the motor axis 26 mm above the bottom of the foot (30 mm on the Y mount). 22.6 cm³ (the Y mount is 30.8 cm³). It floats about 36 mm above the upright, not fitted yet. The X motor is still outside the base.
- **Upright.** In the middle of its curved top edge there is now a flat area, 80 × 20 mm, 105 mm above the base, with a small separate block (9.5 × 20 × 5 mm) on it. This is the start of the seat for the X motor mount. 166.9 → 170.9 cm³.
- **The broken mirrored upright is gone**, so only one upright is left in the model. I'm reworking the upright: it will be mirrored again and then changed, because the two won't be the same. One carries the X motor and the other the X idler.
- **CNC setup** for the base, saved in the same file (above).
- The bed and the X carriage are at another point of their travel, otherwise unchanged.

## The model today
Measured on the STEP export of the 24th, parts changed on this day only. Heights are from the top of the base. The idler support and the base are in the [2026-10-22 entry](2026-10-22.md#the-model-on-this-day); the rest is as on [2026-10-20](2026-10-20.md#the-model-today) and [2026-10-19](2026-10-19.md#the-model-on-this-day).

| Part | Qty | In the model |
|---|---|---|
| X motor mount | 1 | L bracket, 49 mm wide with the gussets, 47 mm tall and 43 mm deep. 5 mm plate with the 23 × 24 mm window and 4 × Ø3.4 on the 31 mm NEMA 17 pattern. 5 mm foot with 2 × Ø3.4 holes 21.5 mm apart, under the motor, without nut pockets. 2 gussets 3 mm thick. Motor axis 26 mm above the bottom of the foot. Not fitted yet |
| Upright | 1 | As on 2026-10-20, plus the flat 80 × 20 mm area on top, with the 9.5 × 20 × 5 mm block |
| Upright (mirrored) | 0 | Deleted, to be redone |
| Not placed yet | | The X motor, the X idler and the MG90S servo |

- **Y belt:** about 780 mm around the motor pulley and the idler (axes 368.5 mm apart, 20 teeth), plus what goes into the clamp.

## Checks before building
- **The clamp at the belt line**, about 15 mm under the bed, so the top run is straight from the motor pulley to the idler.
- **Sideways line-up of the Y belt.** In the model, the toothed part of the motor pulley (7 mm wide) is centred 1.2 mm to the side of the idler's (6.5 mm wide), so a 6 mm belt can't run straight on both without touching a flange. When fitting the belt, slide the pulley about 1.2 mm towards the end of the motor shaft (it is held by grub screws).
- **Height of the Y motor.** The printed mount has the 9 mm foot, so in the model the top of the motor is 0.5 mm under the bed. Check it on the machine when the bed goes on.
- **Foot screws of the X motor mount.** The new mount repeats the layout that caused trouble today: its 2 foot holes are under the motor, and the motor sits right on the 5 mm foot, so there's no room for a nut or a screw head on top. Move them to ears at the sides before printing it.
- **Nut of the idler axle.** The idler supports were printed without a hex pocket for the M5 nut, so it needs a second key to tighten.
- **Joint of the idler support.** The fillet between each tab and its foot is R2, and 3 to 5 mm was suggested on the 22nd. Keep an eye on it once the belt is tight.

## Screws for the new parts
For the Y idler support, which is the one in the model. The [2026-10-12 list](2026-10-12.md#screws) covers the rod supports, and the [2026-10-13 to 17 list](2026-10-13_to_2026-10-17.md#screws-for-the-new-parts) the motor mount.

| Joint | Qty | Screw | Nut |
|---|---|---|---|
| Idler support → base | 4 | M3 × 20, from under the base | Hex pocket in the foot |
| Idler axle | 1 | M5 × 25, through both tabs and the idler | M5 and a washer, on the outside of the other tab |

## Pending
For both days:
- Screw the idler support to the base, put the bed on its bearing blocks and make the belt clamp under the bed, at the belt line.
- Fit the Y belt with its spring, line it up and set the tension.
- X axis: redo the second upright (mirror it, then change it for the idler), fit the X motor mount on the upright, print the 2 uprights and the X motor mount, then the X idler, the X belt and its clamp.
- Pen lift (Z): place the servo on the X carriage with a pen holder, then find the S values for pen up and pen down.
- Save the `$$` output in [firmware/grbl_config.txt](../../firmware/grbl_config.txt).
- Fill the misplaced counterbores under the base, only for looks.

Also still to do:
- Route the cables.
- Import the screws, nuts and other standard parts into Fusion, all at once at the end.
- Fix the 3D printer.

## Sketch
Two pen sketches of the Y belt, drawn for the question about the belt line (not in the repository, like the notebook scans). The idler (*polia livre*) is at one end, the motor at the other, and the clamp (*encaixe*) on a line above them, with arrows for the bed moving both ways. The lower run is straight and the top run goes up to the clamp, making a triangle: in the first sketch with the clamp halfway, in the second with the clamp near the motor.

## Photos
| # | Photo |
|---|---|
| F011 | [The CNC router cutting the outline of the base out of the 600 × 600 mm MDF sheet](../photos/F011.jpg) |
| F012 | [Printing the 2 idler supports, with tree supports under the pins, and the Y motor mount behind them](../photos/F012.jpg) |
| F013 | [The same print from the side, with the gussets of the motor mount](../photos/F013.jpg) |
| F014 | [The Y axis on the base: 4 rod supports, 2 rods, 4 bearing blocks and the Y motor in its mount. The 4 holes on the right are for the idler support](../photos/F014.jpg) |

## Fusion 360
CAD exports of this day, at commit 5d40c58: [STEP](https://github.com/audreifilhorossato/InkHand/blob/5d40c58/hardware/cad/Plotter_Pen_InkHand.step) · [Fusion 360 archive (.f3z)](https://github.com/audreifilhorossato/InkHand/blob/5d40c58/hardware/cad/Plotter_Pen_InkHand.f3z). The files in `hardware/cad/` now hold the latest export.

## Next step
Screw the idler support down, put the bed on, make the belt clamp at the belt line and fit the Y belt. Then the second upright and the X motor.
