audreifilhorossato/InkHand/docs/journal/2026-10-10.md

# 2026-10-10 · Session 3 · Repository and first Fusion 360 parts

Notebook page 4.

## Goals
- [x] Create the repository
- [x] Add the files
- [ ] Fix the P4 (DC barrel) power connector so it sits firmly
- [x] Draw the basic parts in Fusion 360

## Done
- Created the repository on GitHub and added the basic files (README, license, .gitignore, journal, firmware and hardware notes).
- First parts modelled in Fusion 360:
  - 10 × LM8SUU linear bearings (the short LM8UU, 16 mm long)
  - 4 × rods
  - Base
  - 2 × NEMA 17

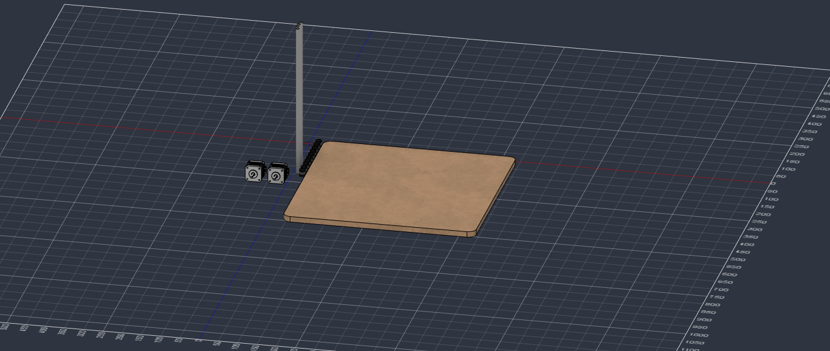
[picture p72: docs/img/fusion-2026-10-10.png]
Fusion 360 assembly, 2026-10-10


STEP export of this day: [Plotter_Pen_InkHand.step at commit 43bfe0b](https://github.com/audreifilhorossato/InkHand/blob/43bfe0b/hardware/cad/Plotter_Pen_InkHand.step). The file in `hardware/cad/` now holds the latest export.

## Pending
- Fix the P4 power connector.

## Tools
- Fusion 360
- GitHub
