audreifilhorossato/InkHand/docs/journal/2026-10-08.md

# 2026-10-08 · Session 1 · Parts and planning

Notebook page 1.

## Done
- The AliExpress order arrived: belts, pulleys, motors, CNC shield, drivers and rods.
- Started documenting the project in the lab notebook.

## Goals
- Buy the missing parts:
  - [x] Servo: Tower Pro MG90S (metal gear)
  - [x] LM2596 adjustable step-down regulator, 5 V for the servo
  - [ ] Optional: limit switches
- [ ] Create the repository: README, license, .gitignore
- [ ] Read and develop the project plan
- [x] Buy MDF

## Next step
Bench-test the electronics (session 2).
