audreifilhorossato/InkHand/docs/journal/2026-10-09.md

# 2026-10-09 · Session 2 · Electronics and firmware bench test

Duration: ≈ 2 h 30 min · Notebook pages 1–3

## Goal
Bench-test the Arduino UNO, CNC Shield V3, 2 × DRV8825 and 2 × NEMA 17 before building the frame.

- [x] Test the NEMA 17 motors
- [x] Test the Arduino
- [x] Test the shield
- [x] Test the drivers
- [x] Set the driver current

## Materials
- Arduino UNO × 1
- CNC Shield V3 × 1 *(notebook says V3.2, the board is printed VER 3.00)*
- DRV8825 × 4 (2 in use)
- NEMA 17 (17HS4401S) × 2
- 12 V 5 A power supply × 1
- Multimeter × 1
- Windows PC × 1

## Done
1. M0, M1 and M2 jumpers on the X and Y slots → 1/32 microstepping.
2. Drivers seated with the EN pin aligned to EN on the shield.
3. Motor coils identified with a multimeter (Ω): red + green | blue + black.
4. X and Y Vref set between 0.48 and 0.52 V, target 0.50 V (black probe on the terminal's −, red on the potentiometer).
5. GRBL 1.1f with servo support flashed to the UNO (grbl-servo fork, `grbl-servo-eggbot` ZIP).
6. UGS connected on COM6 at 115200 baud, replied `Grbl 1.1f`.
7. Settings: `$100=$101=160`, `$110=$111=3000`, `$120=$121=300`.
8. `G91 G1 X40 F1000` and `G91 G1 Y40 F1000`: each motor turned exactly one revolution, smoothly, and came back with X−40 / Y−40.

## Measurements
- Motor current: 1.0 A (≈ 60 % of the 1.7 A rating); motor and driver stay cool.
- DRV8825: I = 2 × Vref (R100 sense resistors = 0.1 Ω) → Vref = 0.50 V.
- Steps/mm = (200 × 32) ÷ (20 teeth × 2 mm) = 160.
- One turn of a 20-tooth GT2 pulley = 40 mm.
- Arduino 5 V rail (shield SV/GND pins): 4.91 V, OK (F004).

## Problems → fixes
- *Add .ZIP Library* failed in Arduino IDE 2 → copied the `grbl` folder manually to `Documents\Arduino\libraries`.
- Low-memory warning when uploading → normal for GRBL, not an error.
- Sent three `$` commands at once → only `$100` was stored, `$110` got corrupted. GRBL ignores serial while writing to EEPROM. Fix: Soft Reset, then **one command at a time, waiting for `ok`**.
- Command typed but nothing in the console → UGS was paused after the error; disconnect and reconnect.
- Wired the motors wrong twice; nothing burned. Motor didn't turn → the cable was on the **END STOPS** header, then by mistake next to the **5 V/GND** pins. Moved it to the 4-pin header by the X driver. Checked nothing was damaged (ON LED, UGS connects, 5 V OK, motor turns).

## Decisions and why
- 1.0 A instead of the planned 1.5 A (Vref 0.50 V instead of 0.53 V): a pen plotter has a light load, and less current means less heat.
- `$110=3000` and `$120=300` instead of the planned 6000/800: conservative values for an unloaded test. To be revisited during calibration with the mechanics built.
- Rule, underlined in the notebook: **"Always power everything off before touching anything."** Never plug or unplug a motor with the power supply on.

## Pending
- Servo hasn't arrived yet.
- Set the LM2596 to 5.0 V **before** connecting the servo.
- Servo signal on Z+ (D11), power from the LM2596, common GND.
- `$30=255`, test `M3 S30` / `M5`.

## Sketch
Page 3 has a hand sketch of the CNC Shield: X and Y drivers seated, empty Z and A slots with their M0/M1/M2 jumpers, reset button and power terminal.

## Photos
| # | Photo |
|---|---|
| F001 | [Bench overview](../photos/F001.jpg) |
| F002 | [Shield top view with both drivers seated](../photos/F002.jpg) |
| F003 | [Motor cables on the X and Y headers, microstep jumpers in the empty slot](../photos/F003.jpg) |
| F004 | [Measuring the 5 V rail: 4.91 V](../photos/F004.jpg) |
| F005 | [Motor label: Usongshine 17HS4401S](../photos/F005.jpg) |

## Next step
Test the servo when it arrives; continue the mechanical design in Fusion 360.
