audreifilhorossato/InkHand/(commit log)

2026-10-10 Add project documentation and folder structure
    - README with project overview, hardware table and repo layout
    - MIT license
    - Lab journal: index and 2026-10-09 electronics bench test
    - Firmware notes and GRBL settings ($100/$101=160 steps/mm)
    - Bill of materials and wiring notes
    - Placeholder folders for C++ source, data, samples, photos and CAD
    - .gitignore: keep handwriting scans, private glyphs and G-code out of Git
    [grbl_config.txt]
2026-10-10 Transcribe lab journal and add bench test photos
    - Journal: add 2026-10-08 (session 1) and merge notebook pages into 2026-10-09
    - Drop phase numbers from journal entries
    - Photos F001-F005 from the electronics bench test (resized to 1600 px)
    - README: use F001 as the header image
    - BOM: 4 x DRV8825, LM2596 step-down, Tower Pro MG90S servo
    Claude-Session: https://claude.ai/code/session_01HT3jfNRUdzuu9DmmDLBTb4
2026-10-11 Add 2026-10-10 journal entry and first Fusion 360 export
    - Journal: session 3, repository created and first CAD parts
    - CAD: STEP export with base, 4 rods, 10 x LM8UU bearings and 2 x NEMA 17
    - Fusion 360 screenshot in docs/img
    - README: update project status
    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
    [Plotter_Pen_InkHand.step]
2026-10-12 Add 2026-10-11 journal entry and Y-axis Fusion 360 export
    - Journal: session 4, frame choice (fixed gantry in X, moving bed in Y)
    and the day's design decisions
    - Journal: Fusion model vs. detailed design (rod supports, 250 mm rod
    spacing, 4-screw bearing blocks, bed and writing sheet)
    - CAD: STEP updated (rod supports, Y rods, bearing blocks, bed) and
    Fusion 360 archive (.f3z) added
    - Fusion 360 screenshots of the assembly and the bearing block in docs/img
    - README: update project status and motion hardware
    - BOM: rods, LM8SUU bearings, M3 screw kit, writing sheet
    - 2026-10-10 entry: bearings are LM8SUU, STEP link pinned to that commit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
    [Plotter_Pen_InkHand.f3z, Plotter_Pen_InkHand.step]
2026-10-13 Add 2026-10-12 journal entry and X gantry Fusion 360 export
    - Journal: session 5, screw holes and joints fixed, writing sheet on
    the bed, X gantry with the rods side by side and the pen between them
    - Journal: model vs. design (uprights, carriage, rod spacing), M3 screw
    list and checks for screw heads and the X belt
    - CAD: STEP and Fusion 360 archive (.f3z) updated
    - Fusion 360 screenshots of the assembly and a side view in docs/img
    - README: update project status and linear motion
    - BOM: servo and LM2596 arrived, carriage plate, writing sheet size,
    M3 screw lengths
    - CAD README: component names, history row for 2026-10-11
    - Wiring and firmware notes: servo and LM2596 arrived, test pen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
    [Plotter_Pen_InkHand.f3z, Plotter_Pen_InkHand.step]
2026-10-17 Add 2026-10-13 to 2026-10-17 journal entry and Fusion 360 export
    - Journal: session 6, no notebook pages, one entry for five days
    - Journal: servo and LM2596 test, draft prints (rod holes from 7.8 to
    8.0 mm), motor mounts, Arduino + CNC Shield and GT2 pulleys
    - Journal: model changes, checks for the Y motor height, the motor
    mount screws, the Arduino holes and the 3 mm counterbores
    - Photos F006-F008: CNC Shield, draft prints and servo test wiring
    - Fusion 360 screenshots of the assembly and a motor in its mount in docs/img
    - README: update project status, pen lift and pulleys
    - BOM: servo and LM2596 tested, pulley bore, tensioner springs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
    [Plotter_Pen_InkHand.f3z, Plotter_Pen_InkHand.step, grbl_config.txt]
2026-10-21 Add 2026-10-19 and 2026-10-20 journal entries and Fusion 360 export
    - Journal: session 7 (2026-10-19, notebook page 8) and session 8
    (2026-10-20, no notebook page); the split between the two days is a
    reconstruction and both entries say so
    - 2026-10-19: counterbores from 3.0 to 3.3 mm, Arduino holes
    counterbored, LM2596 and MG90S models from GrabCAD, LM2596 on 2
    standoffs, Y motor placed, motor mount reinforced with side gussets,
    holes in the base, first 4 final bearing blocks printed
    - 2026-10-20: lighter rod supports (A shape) and upright (X windows,
    trussed gussets), all 8 bearing blocks printed and assembled, test
    print of a rod support, print settings (Bambu Lab X1 Carbon,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
    [Plotter_Pen_InkHand.f3z, Plotter_Pen_InkHand.step]
2026-10-25 Add 2026-10-22 and 2026-10-23 journal entries and Fusion 360 export
    - Journal: session 9 (2026-10-22) and session 10 (2026-10-23), no
    notebook pages; the split between the two days is a reconstruction
    and both entries say so
    - 2026-10-22: idler support from a single plate to a fork with an M5
    axle, GT2 idler in the model, 4 holes for it in the base, the other
    3 rod supports printed
    - 2026-10-23: belt line (the clamp under the bed has to come down to
    the top run), CNC setup in Fusion 360 and the base machined from a
    600 x 600 x 15 mm MDF sheet, misplaced counterbores redrilled by
    hand, motor mount screws under the motor, idler supports and Y motor
    mount printed, Y axis assembl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
    [Plotter_Pen_InkHand.f3z, Plotter_Pen_InkHand.step]
2026-10-29 Add 2026-10-26 and 2026-10-27 journal entries and Fusion 360 export
    - Journal: session 11 (2026-10-26) and session 12 (2026-10-27), no
    and the work of 2026-10-28 is left out
    - 2026-10-26: both uprights redrawn, one with the X motor plate on top
    and one with the X idler fork, idler axle at the height of the motor
    shaft (131 mm above the base); fan support over the shield; first
    upright print failed overnight
    - 2026-10-27: Arduino, LM2596 and DC jack fixed and wired on the base,
    LM2596 header pins replaced by wires to the 12 V input, hot glue on
    the joints, one Arduino standoff shortened, 40 mm fan placed over the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
    [Plotter_Pen_InkHand.f3z, Plotter_Pen_InkHand.step]
2026-11-06 Add 2026-11-05 and 2026-11-06 journal entries and Fusion 360 export
    Journal entries for the two build days: the belt support under the bed
    and its holes in the bed, the bed cut on the CNC router (Stock to Leave
    and work offset fixed in the CAM), the belt clamp plates, the Y belt
    with its tension spring, fan support v2 and v3, and the machine
    assembled. Includes the check that the belt clamp sits 6 mm under the
    belt line.
    Photos F022 to F030, Fusion 360 images, the new STEP and .f3z exports
    (design version 51), and updates to the README, BOM, wiring notes, CAD
    notes and the journal index.
    [Plotter_Pen_InkHand.f3z, Plotter_Pen_InkHand.step]
2026-11-11 Add 2026-11-10 journal entry and Fusion 360 export
    Journal entry for the day: the writing sheet cut on the laser cutter in
    3 mm acrylic, the Y belt support made 4 mm shorter, the X belt clamp on
    the carriage plate with the plate's new holes and counterbores, the fan
    box in two parts, the new parts printed on an A1 mini, and the pen lift
    (Z) chosen. Includes the check that both belt clamps still sit about
    3 mm under their belt lines in the model, and the pen length left under
    the X belt.
    Fusion 360 images, the new STEP and .f3z exports (design version 55),
    the laser file of the writing sheet, and updates to the README, BOM,
    wiring notes, CAD notes and the journal index.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
    [Plotter_Pen_InkHand.f3z, Plotter_Pen_InkHand.step, writing-sheet.dxf]
2026-11-13 Add 2026-11-12 journal entry and Fusion 360 export
    Journal entry for the day: the support of the pen lift (Z) drawn on the
    X carriage plate (a frame with 2 vertical Ø8 × 45 mm rods and 2 caps,
    with the X belt passing through the middle), the fan box with one of
    its legs now a separate part screwed on, because the stiffer print no
    longer bends to snap onto the shield, the Y belt clamp plates with
    bigger counterbores (Ø6.4), and 4 counterbores removed from the X
    carriage plate. Includes what the frame leaves for the pen carriage
    (about 9 mm of travel, the X belt crossing the middle of the rods) and
    the checks and next steps for assembling the machine again.
    Two Fusion 360 screenshots, an i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
    [Plotter_Pen_InkHand.f3z, Plotter_Pen_InkHand.step]
2026-11-13 Add the 2026-11-12 CAD commit to the CAD history
    Claude-Session: https://claude.ai/code/session_01QznDWYn9vUXCdM4M3d9Kpm
2026-11-14 Add 2026-11-13 journal entry and Fusion 360 export
    Yesterday's prints redone: Z frame and caps with solid bases and
    Ø8.6 rod sockets, fan box with a 2-screw leg and back on the Arduino
    holes, Y belt support as a solid block with 8 nuts printed in. New
    STEP and .f3z (design version 62), Fusion screenshots, the reprint
    plate and before/after renders. README, BOM, CAD notes, wiring notes
    and the journal index updated; the CAD links of the 10th and 12th
    pinned to their commits.
    Claude-Session: https://claude.ai/code/session_01QznDWYCPuLMjAhfb7YLsCR
    [Plotter_Pen_InkHand.f3z, Plotter_Pen_InkHand.step]
2026-11-14 Add the 2026-11-13 CAD commit to the CAD history
    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
